leshy/go2skate/go2skate/data/foot_detachable_mm.stl

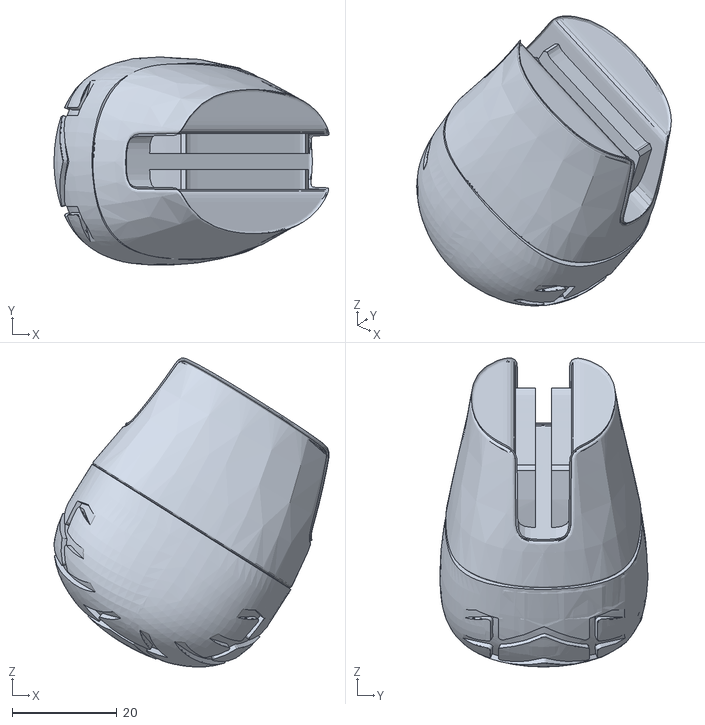
[picture p5: CAD file, 2026-11-09]
go2skate/data/foot_detachable_mm.stl
52.6 x 39.8 x 59.1
