leshy/go2skate/models/wheel_foot_FL.step

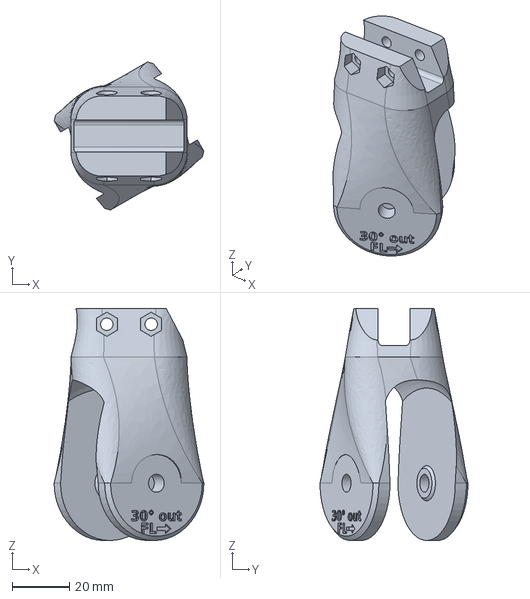
[picture p6: CAD file, 2026-11-12]
models/wheel_foot_FL.step
52.3 x 51.7 x 81.0 mm
