leshy/go2skate/print/wheel_foot_RR_inner.stl

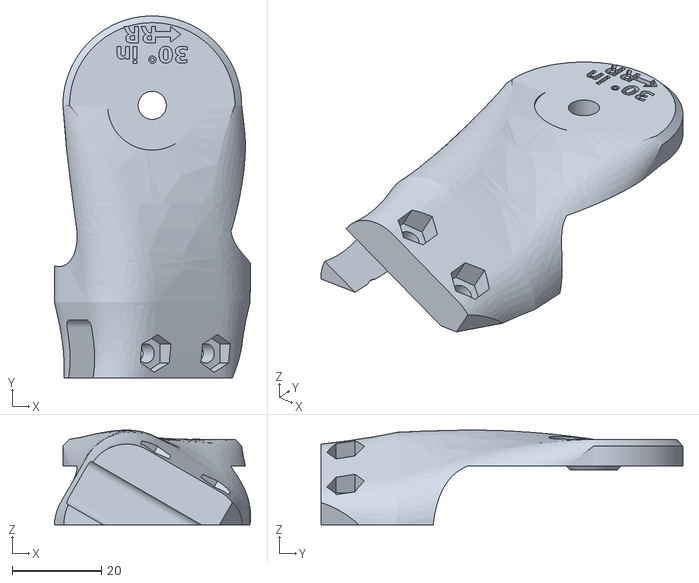
[picture p7: CAD file, 2026-11-12]
print/wheel_foot_RR_inner.stl
43.9 x 81.0 x 21.2
