leshy/go2skate/sim/generated/meshes/wheel_RL.stl

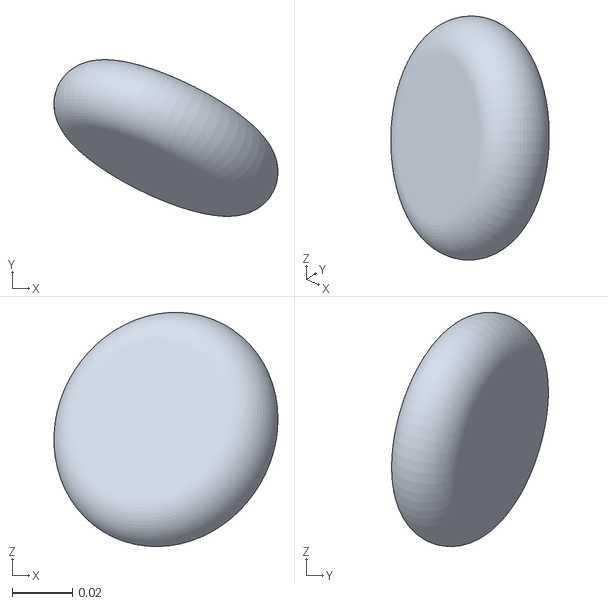
[picture p8: CAD file, 2026-11-12]
sim/generated/meshes/wheel_RL.stl
0.0746 x 0.0522 x 0.078
