leshy/go2skate/go2skate/data/calf_upper_mm.stl

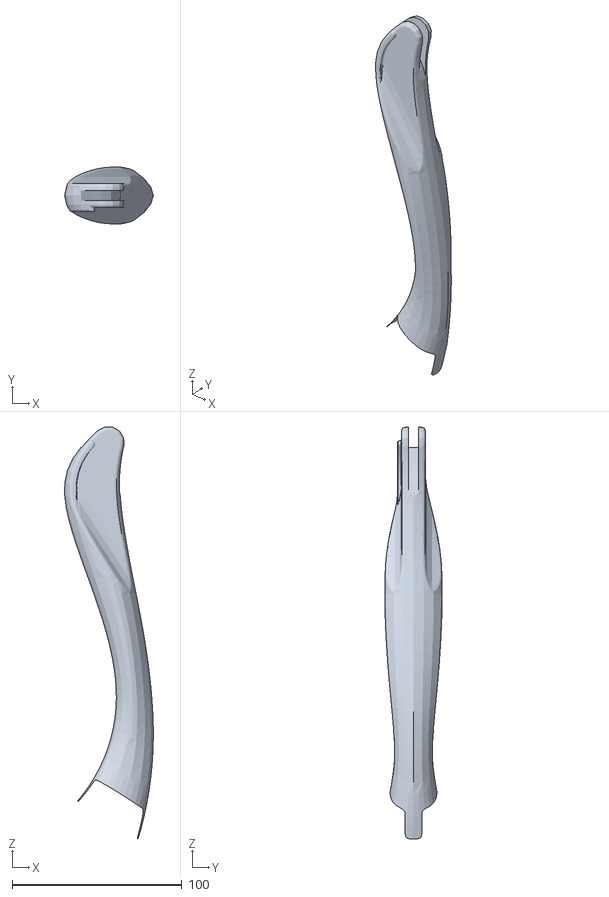
[picture p9: CAD file, 2026-11-09]
go2skate/data/calf_upper_mm.stl
52.2 x 33.7 x 242.6
