leshy/go2skate/print/wheel_foot_RL_outer.stl

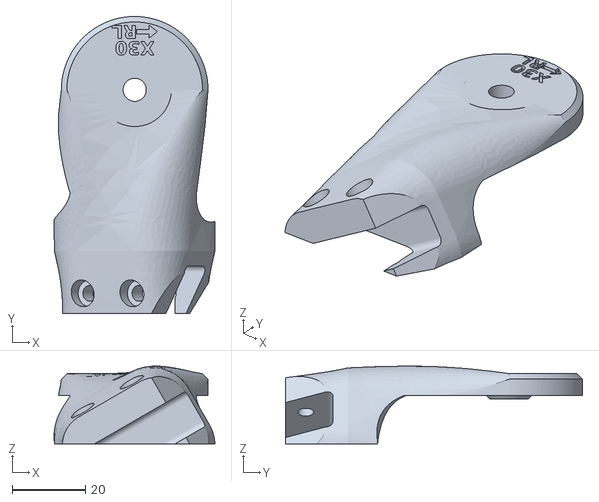
[picture p10: CAD file, 2026-11-12]
print/wheel_foot_RL_outer.stl
43.9 x 81.0 x 21.2
