leshy/go2skate/sim/generated/meshes/skate_RR.stl

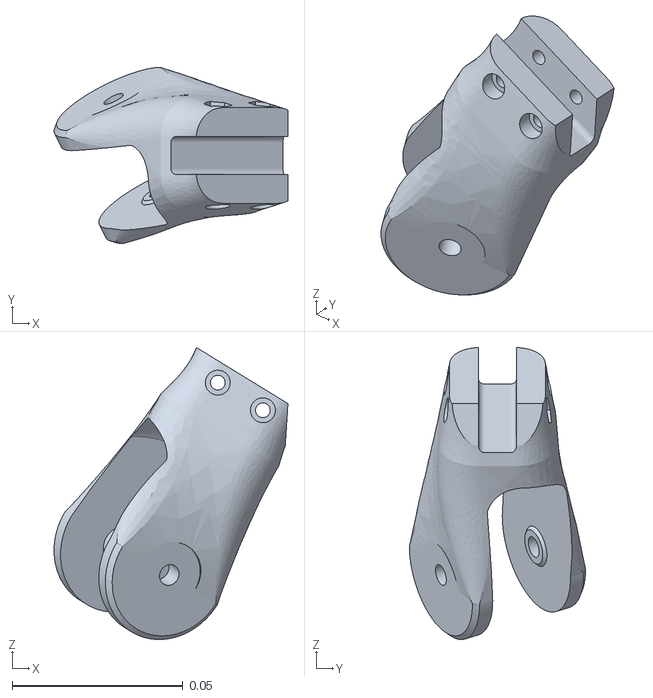
[picture p11: CAD file, 2026-11-12]
sim/generated/meshes/skate_RR.stl
0.0686 x 0.0517 x 0.0856
