leshy/go2skate/models/foot.step

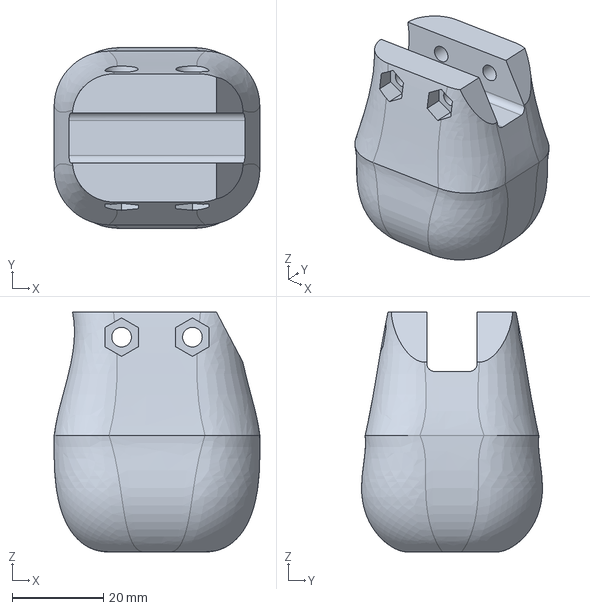
[picture p12: CAD file, 2026-11-12]
models/foot.step
45.0 x 39.6 x 52.5 mm
