leshy/go2skate/models/foot_detachable_foot_frame.stl

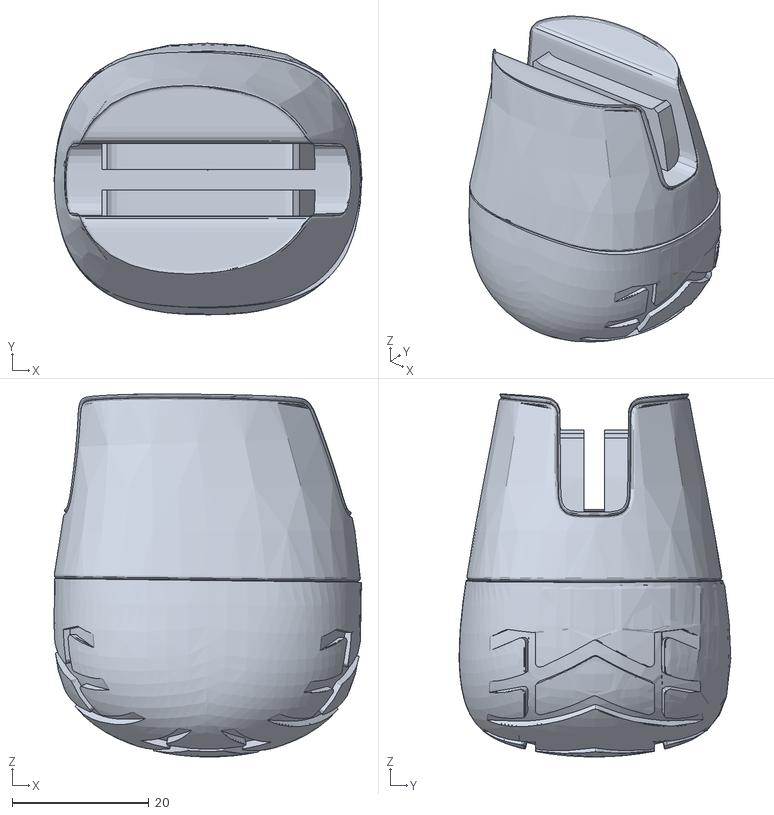
[picture p13: CAD file, 2026-11-11]
models/foot_detachable_foot_frame.stl
45.1 x 39.8 x 53.2
