leshy/go2skate/models/tongue.stl

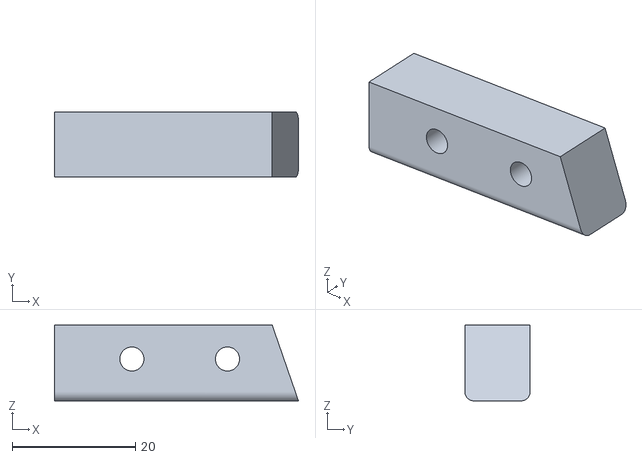
[picture p14: CAD file, 2026-11-11]
models/tongue.stl
39.6 x 10.6 x 12.3
