leshy/go2skate/sim/generated/meshes/tread_RL.stl

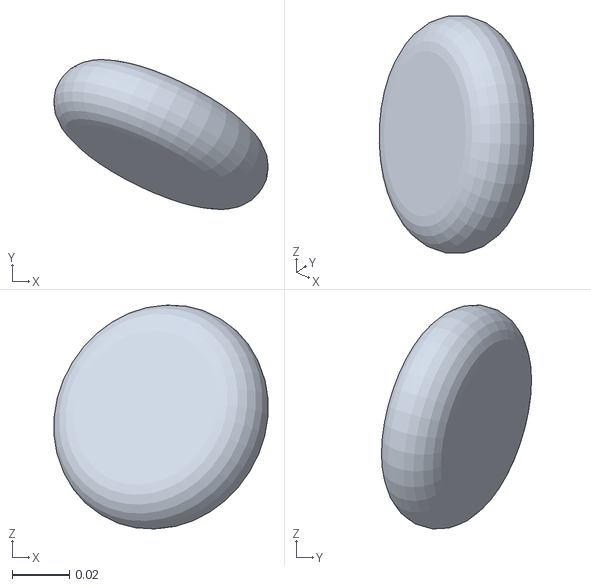
[picture p15: CAD file, 2026-11-11]
sim/generated/meshes/tread_RL.stl
0.0745 x 0.0522 x 0.0778
