leshy/go2skate/print/cup_fit_test.stl

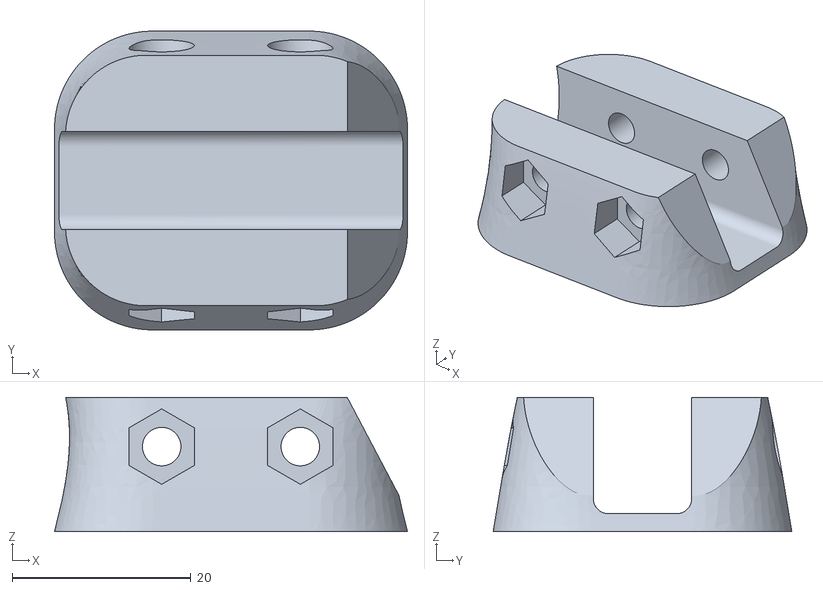
[picture p16: CAD file, 2026-11-11]
print/cup_fit_test.stl
39.5 x 33.4 x 15.0
