leshy/go2skate/sim/generated/meshes/calf_upper_mirror.stl

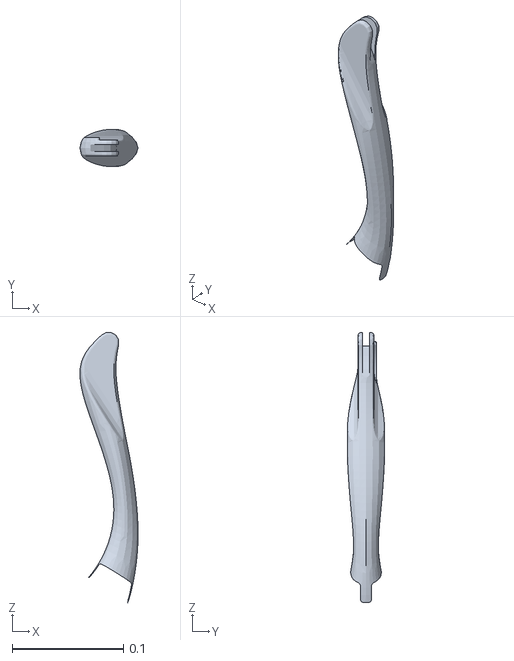
[picture p17: CAD file, 2026-11-11]
sim/generated/meshes/calf_upper_mirror.stl
0.0522 x 0.0337 x 0.243
