leshy/go2skate/(list of files, cad)

Other CAD files:
models/wheel_foot_FR.step
sim/generated/meshes/wheel_RR.stl
models/wheel_foot_RL.step
print/wheel_foot_FL_inner.stl
models/wheel_foot_RR.step
print/wheel_foot_RL_inner.stl
sim/generated/meshes/skate_RL.stl
print/wheel_foot_FL_outer.stl
sim/generated/meshes/skate_FR.stl
print/wheel_foot_RR_outer.stl
sim/generated/meshes/skate_FL.stl
print/wheel_foot_FR_inner.stl
print/wheel_foot_FR_outer.stl
sim/generated/meshes/tread_FL.stl
sim/generated/meshes/wheel_FL.stl
sim/generated/meshes/tread_RR.stl
sim/generated/meshes/wheel_FR.stl
sim/generated/meshes/calf_upper.stl
models/foot.stl
