leshy/go2skate/(commit log)

2026-11-09 Go2 foot end from Unitree's mesh: cup, slot, M4 cross holes, sole; fit-test cup
2026-11-09 Foot: the calf's tongue modelled (plate 10.6 x 17.3 deep, sloped front end, rounded bottom); slot = tongue + 0.2 each side
2026-11-09 Foot: 7 mm pockets, 9 deep, for the M4 heads on the +y ear
2026-11-09 Foot: holes 1 up and 0.5 further apart, from the test print
2026-11-09 Foot: slot 5 shallower (13 deep), from the test print
2026-11-09 Foot: fit test cut 2 under the slot
2026-11-09 Foot: head pockets 7.5; hex M4 nut pockets in the other ear, a corner up
2026-11-09 Foot: M4 heat-set inserts from outside in the other ear (5.5 hole, 1 mm floor to the slot) instead of nuts
2026-11-09 Foot: head pockets and 4 mm inserts both 4 deep: the same plastic behind each
2026-11-09 Wheel foot: the cup over a fork for an inline wheel (608s, 8 mm axle), parametric in wheel size, toe
2026-11-09 Wheel foot: one lofted body from the cup down to the axle, turned TOE, the wheel's sweep plus clearance cut out of it
2026-11-10 Wheel foot: show the 608s, spacer and axle in the viewer
2026-11-10 Configurable: every size, the toe angle and the sim's physics in config.py; uv project; print/ and models/
    config.py holds the wheel, bearings, axle, fork fit and toe-out as frozen dataclasses; wheel_foot.py builds from it.
    Toe-out exports a left foot and its mirror. The axle stack is the axle's length plus 0.3 play, bosses 10.5 on the
    inner races, arm faces pocketed 2 mm off the wheel. Exports go to print/ (what to print) and models/ (STEP/STL).
    pyproject.toml + uv.lock replace the borrowed venv. README: the pieces, running, viewing, configuring, what to buy.
2026-11-10 sim: the Go2 on skates for MuJoCo, generated from the CAD
    gen_mjcf.py swaps each of Menagerie's feet (vendored byte-identical, BSD-3) for the printed wheel foot and a wheel on
    a free hinge, the calf drawn cut off above the stock foot; spec.json carries the same numbers (calf-frame wheel centre,
    per-leg axles, masses and inertias from the B-rep, friction) for whoever trains on it. check.py sets the standing
    height so the wheels touch and holds it under PD; view.py opens MuJoCo's viewer with it standing.
    [calf_upper.stl, calf_upper_mirror.stl, skate_left.stl, skate_right.stl, wheel_left.stl, wheel_right.stl]
2026-11-10 gitignore: Python, editors; track the generated print/, models/ and sim/meshes/ so the defaults need no build
    [cup_fit_test.stl, foot.step, foot.stl, foot_detachable_foot_frame.stl, tongue.stl, wheel_foot.step, wheel_foot.stl]
2026-11-10 Wheel foot: toe out 30° by default, four labelled feet, seamless joints, bosses on the bearings, axle-head seats
    - toe_out_deg 30 (front and rear alike); exports wheel_foot_{FL,FR,RL,RR}, each engraved with its leg and an arrow to
    the robot's front on the fork's outer side (config: label, label_size, label_depth)
    - the fork lofts from the cup's own section (no seam where they meet), and runs on into the round end's lower half at a
    matching cut-corner rectangle (no notches); round ends 40 across, chamfered
    - fix: the bosses reach the bearings' inner races (they stopped 0.9 short), tapered 45° so they print without overhang
    - axle heads (head_d 15) seat on a flat spot-faced round each ar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
    [calf_upper.stl, calf_upper_mirror.stl, foot.step, skate_left.stl, skate_right.stl, wheel_foot.step, wheel_foot.stl, wheel_foot_FL.step]
2026-11-10 sim: generated files move to sim/generated/; the calf drawn cut off above the stock foot
    gen_mjcf.py writes go2skate.xml, scene.xml, spec.json and meshes/ into sim/generated/; check.py and view.py load from
    there. Rebuilt for the current part: 30° toe-out axles per leg, the 53 g bracket.
    [calf_upper.stl, calf_upper_mirror.stl, skate_left.stl, skate_right.stl, wheel_left.stl, wheel_right.stl]
2026-11-10 README images both 800x800 squares, the new viewer screenshot; viewer: charcoal wheel, grey tongue
2026-11-10 STEP exports with a fixed timestamp, so a rerun only changes files whose geometry changed
    [foot.step, wheel_foot_FL.step, wheel_foot_FR.step, wheel_foot_RL.step, wheel_foot_RR.step]
2026-11-10 One printed-fit setting, fit 0.025 a side (tuned on the H2S): axle hole 8.05, M4 holes 4.05, head pockets 7.05
    Heat-set insert holes keep their maker's size; the calf tongue's slot keeps the test-printed 0.2.
    [cup_fit_test.stl, foot.step, foot.stl, skate_left.stl, skate_right.stl, tongue.stl, wheel_foot_FL.step, wheel_foot_FL.stl]
2026-11-10 A Python package with a CLI: go2skate.build(Skate(...), out=...) and go2skate build|check|view; sphere wheel collision
    - the modules move into go2skate/ (config, foot, wheel_foot, mjcf, check, view, cli), their meshes into go2skate/data/
    (Unitree's foot and calf, Menagerie's Go2, untouched), so it installs as a dependency: uv add git+https://github.com/leshy/go2skate
    - go2skate.build(skate, out, cad, sim, stock, show) writes print/, models/, sim/generated/ under out; the CLI's
    --set dotted.field=value overrides any config field, --out picks the folder
    - sim.wheel_collision 'sphere' (default): the wheel's radius at its centre, exact upright for the round tread and ~3x
    faster than the me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
    [calf_0.obj, calf_1.obj, calf_tongue_mesh.stl, calf_upper_mm.stl, foot.obj, foot_detachable_mm.stl, skate_left.stl, skate_right.stl]
2026-11-10 sim: wheel_collision 'hull' option (a convex hull of the tread's round, within 0.3 mm), sphere stays the default
    Measured standing: sphere 39.7k steps/s, the 432-point hull 12.0k, the CAD mesh 31.4k. The training side builds its own
    from spec.json's tread.
    [skate_left.stl, skate_right.stl, tread_left.stl, tread_right.stl]
2026-11-10 Per-leg toe angles (V or X layouts), M4 nut pockets, looser M4 fit
    - config toe_deg = (FL, FR, RL, RR) replaces toe_out_deg: V (30,-30,30,-30) stays the
    default, X is (30,-30,-30,30). Each foot is built at its own angle; the sim gets
    per-leg meshes (skate/wheel/tread_<leg>.stl) and spec.json toe_deg and masses per leg.
    - The far ear takes a sunk M4 hex nut (screws.nut, default on; off: heat-set insert).
    - screws.fit 0.15 a side for the M4 holes, head and nut pockets; the axle keeps fit 0.025.
    - README: wheel layouts, M8 bolt as the axle option, nut in the BOM.
    [cup_fit_test.stl, foot.step, foot.stl, skate_FL.stl, skate_FR.stl, skate_RL.stl, skate_RR.stl, skate_left.stl]
2026-11-10 Trim vendored data: drop Menagerie's previews and MJX variant, and six data files nothing reads
    The remaining Menagerie files are still byte-identical to upstream 4c358ef; PROVENANCE has the new tree hash.
    A full build and check give identical outputs.
    [calf_0.obj, calf_1.obj, calf_tongue_mesh.stl, foot.obj]
2026-11-10 CI: install from the lock, build, check, and fail if outputs differ from the committed ones
    The labels' font is bundled (DejaVu Sans Bold, its license beside it) so the engraving is the
    same on any machine, not whatever "Arial" resolves to.
    [wheel_foot_FL.step, wheel_foot_FL.stl, wheel_foot_FR.step, wheel_foot_FR.stl, wheel_foot_RL.step, wheel_foot_RL.stl, wheel_foot_RR.step, wheel_foot_RR.stl]
2026-11-10 README: a diagram of the wheel layouts (straight, V, X), toe_deg set in config.py
2026-11-10 README: trimmed (layout bullets, collision detail, repeated CLI line), check explained, printed feet in the BOM
2026-11-11 M6 axle through 8->6 inserts, engraved build name and toe, builds/ ignored
    [skate_FL.stl, skate_FR.stl, skate_RL.stl, skate_RR.stl, wheel_foot_FL.step, wheel_foot_FL.stl, wheel_foot_FR.step, wheel_foot_FR.stl]
2026-11-11 split=true prints each foot in two halves along the wheel's plane; axle bolt, washers in config; right legs' arrows engraved
    The halves lie on their cut face, arm flat over the bed, so the layers run along the arm (the one-piece foot broke along a
    layer at the arms' root). The M6 bolt clamps at most bolt - nut_washers; wider arms sink the 18 mm washers. Engravings
    extruded inward on the right legs (a sealed void instead of a cut).
    [skate_FL.stl, skate_FR.stl, skate_RL.stl, skate_RR.stl, wheel_foot_FL.step, wheel_foot_FL.stl, wheel_foot_FR.step, wheel_foot_FR.stl]
2026-11-11 README: a photo of the Go2 on its printed wheel feet
2026-11-11 README: printing advice, split in two unless PPA-CF or similar
2026-11-11 split --show: the halves together round the wheel, one colour each
2026-11-11 README: the BOM's wheel links an image search
2026-11-11 README: the halves in the slicer, under Printing
2026-11-11 CI: pin ubuntu-24.04, retry apt
2026-11-11 STLs written with their normals rounded: CI's CPU put different 1e-13 noise in two of the FR foot's
    [cup_fit_test.stl, foot.stl, tongue.stl, wheel_foot_FL.stl, wheel_foot_FR.stl, wheel_foot_RL.stl, wheel_foot_RR.stl]
2026-11-11 build rounds every output STL's normals at the end (the sim meshes are trimesh's, it recomputes them)
    [calf_upper.stl, calf_upper_mirror.stl, foot_detachable_foot_frame.stl, skate_FL.stl, skate_FR.stl, skate_RL.stl, skate_RR.stl, tread_FL.stl]
2026-11-12 Label both arms with the leg and a front arrow, so a split foot's halves pair up; README: new MuJoCo image
    [skate_FL.stl, skate_FR.stl, skate_RL.stl, skate_RR.stl, wheel_foot_FL.step, wheel_foot_FL.stl, wheel_foot_FR.step, wheel_foot_FR.stl]
2026-11-12 STEP numbers cut to 9 decimals: their 12th differs from CPU to CPU, which failed CI's diff
    [foot.step, wheel_foot_FL.step, wheel_foot_FR.step, wheel_foot_RL.step, wheel_foot_RR.step]
2026-11-12 Default print is X30 split: toe (30,-30,-30,30) and split=true; a split build also writes the whole feet's STEP; README printing in one sentence
    [skate_FL.stl, skate_FR.stl, skate_RL.stl, skate_RR.stl, tread_RL.stl, tread_RR.stl, wheel_RL.stl, wheel_RR.stl]
2026-11-12 README: wheel height and sport-mode caveat under the intro; License in two sentences
